banatanflorin/cric-piulita-rotitoare/Proiect O.M.-Bănățan Florin.pdf

1

UNIVERSITATEA TEHNICĂ DIN CLUJ-NAPOCA

Facultatea de Construcții de Mașini

Departamentul: Ingineria Sistemelor Mecanice

Disciplina: Organe de Mașini 1

## CRICUL CU PIULIŢĂ ROTITOARE

### Fmax =18 800 N

### hmax = 150 mm

Numele şi prenumele: BĂNĂȚAN PETRU-FLORIN

Anul, grupa: II, 2521/1

2020 – 2021

2

Universitatea Tehnică Cluj–Napoca

Facultatea de Construcții de Mașini

Departamentul: Ingineria Sistemelor Mecanice

Disciplina: Organe de Mașini 1

TEMA DE PROIECT

Studentul BĂNĂȚAN PETRU FLORIN , anul II , grupa 2521/1

Să se proiecteze un CRIC CU PIULIŢĂ ROTITOARE, pentru următoarele date:

- Forța maximă: Fmax =18 800N
- Cursa maximă: hmax =150 mm

Proiectul va cuprinde:

- Memoriul tehnic;
- Memoriul justificativ de calcul;
- Desen de ansamblu al mecanismului (3 vederi, scara 1/1);
- Desene de execuție pentru:
- șurubul principal;
- piuliță.
- Bibliografie;
- Cuprins.
Termen de predare | Conducător de proiect
25.05.2021 | ș. l. dr. ing. Claudiu POPA

3

CUPRINS:

I. MEMORIU TEHNIC
4. Justificarea claselor de precizie a ajustajelor și

II. MEMORIU JUSTIFICATIV DE CALCUL

7. Proiectarea mecanismului de acționare cu clichet

4

I.MEMORIU TEHNIC

Obiectul prezentului proiect este proiectarea unui dispozitiv cu șurub și piuliță, mai exact unui cric cu piuliță rotitoare, destinat atelierelor de lăcătușerie sau atelierelor mecanice, unde acesta și-ar găsi utilitatea. Dispozitivul mai sus amintit este fabricat în serie mică, executându-se numai la comandă, fiind utilizat frecvent de către un singur muncitor.

1.Considerente teoretice introductive:
Mecanismele de ridicat (cricurile) au in componenta lor cuple elicoidale de tip șurub-piuliță. Datorita simplității constructive, mecanismele șurub-piuliță se folosesc pentru transformarea mișcării de rotație in mișcare de translație sau invers, in condiții de transmitere ale unor sarcini sau având numai rol cinematic. Caracteristicile cinematice ale mecanismului sunt legate strict de elementul conducător.
Filetul atașat piesei cuprinzătoare si celei cuprinse permite cuplei elicoidale doua mișcări simultane, rotație si translație, intre care exista o relație cinematica: la o rotație completa deplasarea axiala este egala cu mărimea pasului filetului.

Utilizarea mecanismelor cu șuruburi de mișcare în construcția de mașini se datorează avantajelor pe care le prezintă:
- Construcția simplă și tehnologia de execuție ușor realizabilă
- Posibilitatea de transmitere a unor sarcini axiale mari utilizând forțe de acționare mici
- Raportul mare de transmitere i=πd2/p care duce la viteze mici
- Compactitatea construcției și gabarit redus
- Funcționarea lină și fără zgomot
- Posibilitatea de a asigura în mod simplu autofrânarea
- Permite utilizarea materialelor ieftine
- Preț de cost redus

5

Bineînțeles că mecanismele cu șuruburi de mișcare prezintă și următoarele dezavantaje:
- Existența unei frecări în spirele filetului șurubului și piuliței care conduce la uzura pieselor și la randament scăzut
- Prezența unor puternici concentratori de tensiune în zona filetată afectează rezistența la oboseală a șurubului
- Lipsa autocenzurii
Aceste dezavantaje pot fi reduse prin ungerea filetelor șurubului și a piuliței cu scopul de a îmbunătății performanțele cricului prin micșorarea frecării dintre flancurile filetelor. Totodată, prin ungere crește și randamentul mecanismului și se mărește durata sa de funcționare, scade nivelul zgomotelor ce pot apărea în cazul frecării uscate. Pentru ungere se va folosi o unsoare consistentă.

### 2. Alegerea filetului:

Filetul este o nervură elicoidală dispusă pe o suprafață cilindrică sau conică. În cazul șuruburilor această suprafață este exterioară, iar în cazul piulițelor ea este interioară. Există și un caz particular de filet când spirala este dispusă pe o suprafață plană. Din punct de vedere geometric, filetul poate fi generat de o figură pătrată, triunghiulară, trapezoidală sau semicerc, care are o mișcare elicoidală în jurul axei suprafeței de rotație. Pentru cric, știind că avem o deplasare relativ mică a șurubului și direcția forței rămâne constantă, am ales un filet trapezoidal oferind o serie de avantaje.
Filetul trapezoidal are o rezistență și o rigiditate mai mare ca
filetul pătrat. Folosirea | piuliței reglabile radial (secționată)
permite eliminarea jocului axial creat în urma uzurii flancurilor, avantaj care impune filetului trapezoidal ca principală soluție pentru mecanismele șurub-piuliță.
Filetul trapezoidal asigură o bună centrare între șurub și piuliță putându-se executa prin procedeul de frezare.
În cazul mecanismelor cu șurub și piuliță care transmit sarcini mari, în ambele sensuri, direcția forței fiind variabilă (sau cu șoc), se recomandă utilizarea filetelor trapezoidale.

6

Filetul este standardizat în STAS 2114/1-75, putând avea pas normal, fin sau mare. Valorile dimensiunilor sale se determină conform relațiilor de calcul, în funcție de diametrul
nominal și de pasul filetului.

### 3. Alegere materialelor:

Alegerea materialului se face astfel încât unul dintre elementele cuplei de frecare să fie confecționat din material antifricțiune. Materialele antifricțiunii sunt considerate printre cele mai bune materiale pentru lagăre, fiind caracterizate prin: temperatură scăzută de topire și proprietăți bune de turnare, rezistență ridicată la frecare și
compresiune la presiune și viteză mare, stabilitate înaltă la coroziune în diferite substanțe folosite pentru ungere, conductibilitate termică suficientă, aderență corespunzătoare la pereții lagărului, rezistență mare la uzură, precum și o ușoară prelucrare prin așchiere.
Atât în cazul șurubului, cât și în cazul piuliței , materialele se aleg în funcție de sarcina care acționează pe cupa cricului. Șurubul poate fi fabricat din oțeluri necălite sau oțeluri călite, iar piulița, care în general se efectuează din material antifricțiune pentru că este mai simplă și mai ieftină, poate fi fabricată din fonte cenușii, fonte cu grafit nodular sau bronzuri.
Pentru alte elemente ale cricului se aleg materiale din categoria oțelurilor, în majoritatea situațiilor, sau a fontelor.

### 4. Justificarea claselor de precizie a ajustajelor și

rugozităților:
În alegerea acestora trebuie să se ţină seama că aceste mecanisme nu lucrează la viteze mari şi nu se impune o precizie prea ridicată.
Rugozitătile se aleg în funcţie de rolul funcţional al pieselor, astfel pentru flancurile filetelor se alege o rugozitate de 1,6 pentru reducerea frecărilor şi mărirea randamentului, iar pentru restul suprafeţelor se vor alege rugozităţi de 3,2 și 6,3. Se pot alege şi alte rugozităţi dacă e justificat tehnologic şi constructive.

7

Pentru ajustajul filetat s-a ales precizia 8H/8e, fiind în acord cu destinația dispozitivului și tehnologia de execuție. Celelalte toleranțe la dimensiuni s-au ales conform unor clase și precizii medii, deoarece s-a considerat că nu este necesară impunerea unor precizii mai mari. Toleranțele s-au stabilit pe același criteriu, fiind impuse numai acolo unde ar fi existat pericolul unor disfuncții la montare sau demontare și în funcționare.

Condițiile tehnice impuse sunt următoarele:

- suprafețele funcționale și ansamblele componente se vor unge cu unsoare consistentă;
- suprafețele nefuncționale se protejează printr-un strat de vopsea;
- pe suprafețele pieselor turnate nu se admit urme de nisip, zgură sau bravuri provenite din turnare;
- muchiile necotate se vor teși la 45°

### 5. Prezentarea variantei constructive alese:

Variantele constructive ale cricului cu piuliță rotitoare sunt diversificate, diferențele dintre ele fiind legate de construcția corpului. Prima variantă de cric aleasă este cricul cu piuliță rotitoare care are următoarele particularități: corpul cricului este sudat și alcătuit din trei piese care pot fi obținute din semifabricate laminate, manivela cricului este cu clichet orizontal, corpul manivelei putându-se realiza prin forjare sau turnare. A doua variantă este cricul cu piuliță rotitoare, la care corpul este obținut prin turnare și roata de clichet este corp comun cu piulița. Cricul se acționează prin intermediul unei manivele cu clichet orizontal, care, pentru a putea fi montată, este executată cu două părți îmbinate prin intermediul unor șuruburi centrate cu ajutorul unor știfturi. Între extremitățile libere ale pieselor care formează manivela este introdusă o plăcuță de distanțare.

Deoarece ambele variante constructive au atât avantaje, cât și dezavantaje, am ales din fiecare formă părți constructive

8

pentru realizarea unei variante optime. Astfel cupa va fi fixată în partea superioară a șurubului printr-un știft standardizat, formând un alezaj cu joc. Pentru mecanismul de acționare am ales roate cu clichet orizontal fiind cea mai compactă. Roata de clichet se va fixa pe piuliță prin intermediul unei asamblări de formă hexagonală, iar tija, de care se prinde și clichetul utilizând un bolț, cu ajutorul unei piese inelare care este asigurată în partea superioară printr-un inel elastic. Piulița este împiedicată să facă mișcare de translație cu ajutorul unui știft filetat cu cep, asamblat prin corpul cricului. Pentru a evita frecarea dintre piuliță și corp se folosește un rulment axial cu rol în protecția la uzură. Pentru că producția va fi de serie mică, corpul cricului se va realiza prin sudura a trei piese. Șurubul va fi fixat de corp în partea inferioară cu ajutorul unui știft standardizat cu rolul de a împiedica mișcarea de rotație a șurubului și de a-l opri pe acesta la capătul cursei.

### 6. Funcționare:

Principiul de funcționare este relativ simplu realizându-se astfel: la rotirea manivelei mișcarea se transmite prin piuliță, care se sprijină pe rulment, la șurub care va face o mișcare de translație, cu ajutorul căruia se deplasează cupa.

Pentru o bună funcționare dispozitivul trebuie să îndeplinească următoarele condiții:

- Mânuire, antrenare, manipulare ușoară
- Gabarit cât mai redus
- Curse utile cât mai mici
- Siguranța în funcționare
- Posibilitatea de producere a accidentelor cât mai redusă
- Posibilitatea mânuirii fără a necesita scule sau dispozitive speciale

9

### 7. Indicii de exploatare, reglaj și întreținere:

Dispozitivul se va manevra de către un singur muncitor, nefiind permisă, pentru manipulare, folosirea altor țevi, bare, prelungitoare decât cele prevăzute de proiectant, sau sistemelor de pârghii.

Este indicat ca dispozitivul să fie montat pe suprafețe cât mai plane și orizontale.

Dispozitivul se va folosi pentru sarcini și dimensiuni care nu va depăși limita pentru care a fost proiectat.

Se vor verifica periodic flancurile filetului, iar în caz că se constată uzura acestora, se va schimba piulița sau șurubul dacă este cazul.

După fiecare utilizare dispozitivul se va curăța, suprafețele funcționale se vor unge cu unsoare consistentă de uz general.

### 8. Norme de protecția muncii:

Pentru a evita accidentele, proiectantul a luat următoarele măsuri:

✓ Verificarea șurubului la solicitării compuse
✓ Asigurarea și verificarea asamblării
✓ Utilizarea de materiale corespunzătoare

Măsuri impuse beneficiarului:

✓ Trebuie respectate regulile de protecție a muncii din atelierul de producție
✓ Personalul de lucru trebuie să fie instruit corespunzător ✓ Dispozitivul de strângere nu se va supune la șocuri și lovituri directe
✓ La apariția unei defecțiuni se va retrage dispozitivul din lucru și se va înlocui piesa defectă
✓ Asamblarea șurub-piuliță se va unge periodic cu unsoare consistentă

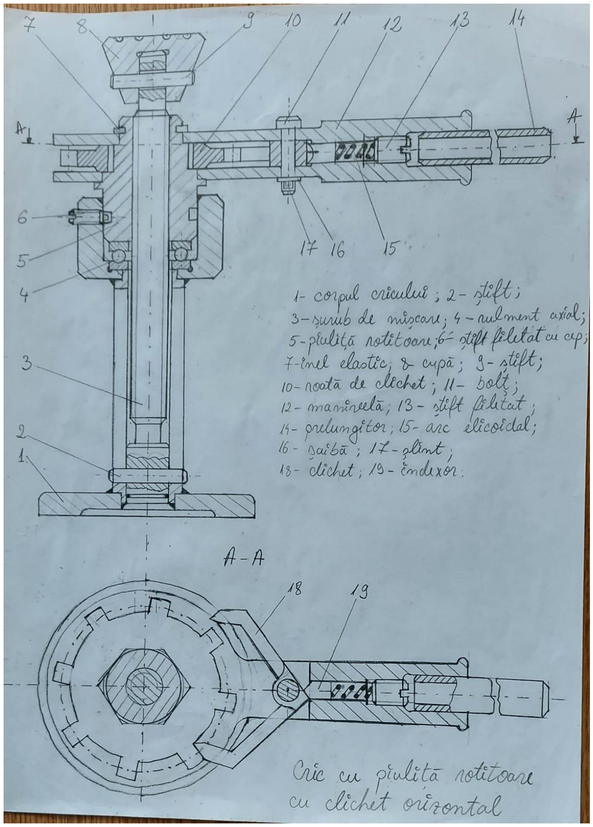
[picture p1: figure]

10

### 9. Schiță constructivă:

### II. MEMORIU JUSTIFICATIV DE CALCUL

Date de intrare: F≔18800 N
x≔150 mm
1.Dimensionarea asamblării filetate:

Se utilizează FILETUL TRAPEZOIDAL deoarece transmite sarcină în ambele sensuri, având coeficientul înălțimii spirei:
ψh≔0.5

Se adoptă coeficientul lungimii filetate a piuliței: ψm ≔2

Alegerea materialelor:
-ȘURUBUL se realizează din oțel călit 2C45** cu rezistențele admisibile, preluate din tabelul 1.3:

rezistența la tracțiune: σats≔87 MPa σacs≔87 MPa rezistența la încovoiere: σais≔100 MPa
rezistența la torsiune: τats≔55 MPa
rezistența la forfecare: τafs≔70 MPa

-PIULIȚA se realizează din material cu proprietăți antifricțiune, mai exact fontă cu grafit nodular EN-GJS-400-18 cu rezistențele admisibile, preluate din tabelul 1.4:

rezistența la tracțiune: σatp≔49 MPa rezistența la compresiune: σacp≔123 MPa rezistența la încovoiere: σaip≔83 MPa rezistența la torsiune: τatp≔59 MPa rezistența la forfecare: τafp≔39 MPa

În urma alegerii materialelor se adoptă, cu ajutorul tabelului 1.6 , tensiunile admisibile și coeficienți de frecare pentru cuplul oțel călit/fontă cu grafit nodular:

suprafețe mobile: pa≔8 MPa suprafețe imobile: σas≔40 MPa coeficientul de frecare: μ≔0.10

d2nec≔ | =
――F――― π⋅ψ ⋅ | ⋅ h ψm pa

### 27.35 mm

11

Se adoptă β≔1.3

d3nec≔ | =

―4 ⋅β―⋅F― π⋅σacs
18.912 mm
Se adoptă elementele standardizate ale filetului la care d | ≥ | și | . 2stas d2nec | d3stas≥d3nec

Se adoptă filetul trapezoidal 32 cu elementele standardizate, preluate din tabelul 1.1:
d≔32 mm
P≔6 mm
D2≔29 mm
d2≔29 mm
D4≔33 mm
d3≔25 mm
d1≔26 mm
ac≔0.5 mm

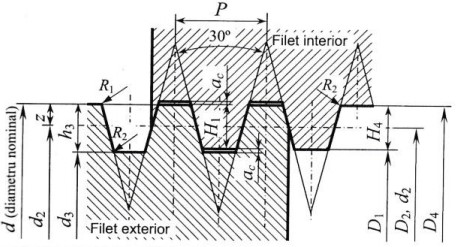
[picture p2: figure]

Se adoptă numărul de începuturi n=1 pentru îndeplinirea condiției de autofrânare:

α1≔15 °

β2≔atan | =

⎛
⎜
⎝

―P―π⋅d2

⎞
⎟
⎠
3.768 ° | φ'≔atan | =

⎛
⎜
⎝

――μ ― cos ⎛⎝α1
⎞
⎠

⎞
⎟
⎠

5.911 °

Concluzie: Este îndeplinită condiția de autofrânare β2<φ'

Momentul de înfășurare T se calculează cu relația: 1

T1≔―⋅ ⋅ ⋅ | =

1
2

F d2 tan⎛⎝β2+φ'⎞
⎠

⎛⎝4.649 ⋅ 10⁴ ⎞
⎠ N ⋅mm

Calculul numărul de spire:

z≔―――=

ψm ⋅d2
P

9.667

Se îndeplinește condiția: 6≤z≤11

Calculul lungimii filetului piuliței:

m≔z ⋅P=58 mm

Se adoptă dimensiunile pentru rulment, cu ajutorul tabelului A16.1 și a condiției: drul>d

drul≔35 mm | Hrul≔12 mm
Drul≔52 mm | μrul≔0.01
12.

Calculul lungimii filetului șurubului:

Lf≔x+m+Hrul+3 ⋅P=238 mm
2.Proiectarea formei șurubului

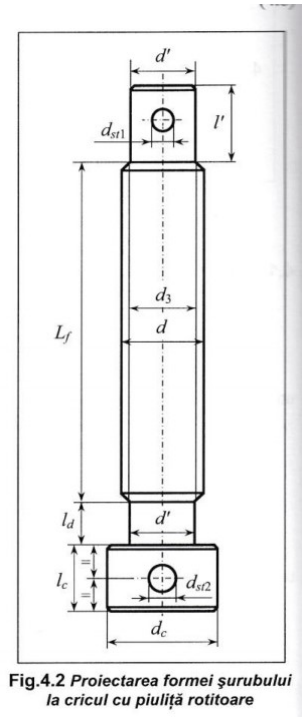
[picture p3: figure]

Se alege d'<d3stas

d'≔24 mm

Lungimea degajării:

ld≔2 ⋅P=12 mm

dc≔d+5 mm =37 mm

lc≔0.8 ⋅dc=29.6 mm

lc≔30 mm

Calculul diametrelor știfturilor:

dst1≔0.3 ⋅d'=7.2 mm

dst2≔0.3 ⋅dc=11.1 mm

Se adoptă știfturi cilindrice de forma B cu diametrele, cu ajutorul Anexei 10:

dst1≔8 mm

dst2≔12 mm

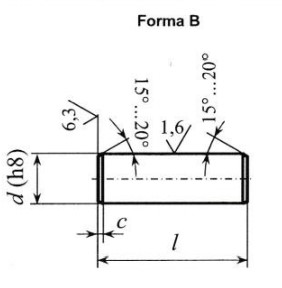
[picture p4: figure]

3.Verificarea șurubului

### 3.1. Verificarea tijei șurubului

Verificarea la solicitări compuse:

σc≔―――=

4 ⋅F
π⋅d ⋅ 3 d3

38.299 MPa

T'≔0.5 ⋅T1=⎛⎝2.325 ⋅ 10⁴ ⎞
⎠ N ⋅mm
τt≔―――= | 13 16 ⋅T'
π⋅d3

3

7.577 MPa

σech≔ σ
c

+ =

2 3 ⋅τt

2 40.485 MPa <= σacs=87 MPa

Verificarea la flambaj:

Lungimea de flambaj: lfl≔2 ⋅x=300 mm

Coeficientul de zveltețe: imin≔―=

| d3
| 4 6.25 mm
| λ≔――= lfl imin
| 48

Verificarea la flambaj nu este necesară deoarece λ≤60

### 3.2 Verificarea spirelor șurubului

H1≔0.5 ⋅P=3 mm

h≔0.634 ⋅P=3.804 mm

σi≔―――――=

6 ⋅F⋅

⎛
⎜

⎝――+

H1
2

ac

⎞
⎟
⎠
z ⋅π⋅d ⋅ 3 h

2

20.535 MPa <=σais=100 MPa

τf≔――――=

F
z ⋅π⋅d ⋅ 3 h

### 6.51 MPa <=τafs=70 MPa

### 4. Proiectarea cupei

dc1≔2.5 ⋅d=80 mm | hc≔1.5 ⋅d=48 mm
dc2≔d'+12 mm =36 mm | hcs≔hc-10 mm =38 mm

y≔――=

hcs
2
19 mm | l'≔hcs+4 mm =42 mm

d''≔d'-2 mm =22 mm

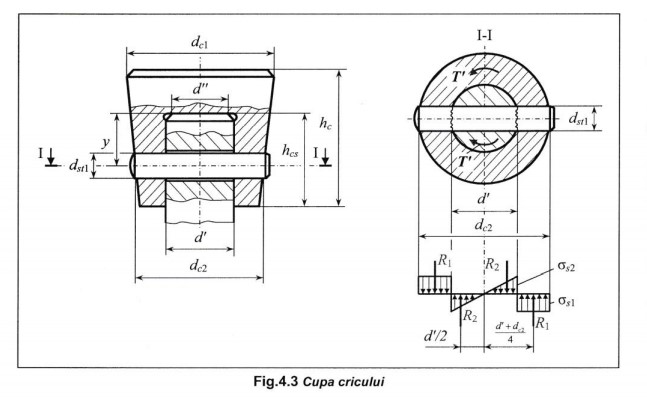
[picture p5: figure]

14

Verificarea cupei:

Deoarece cupa și știftul sunt efectuate din oțel, vom alege din tabelul 1.6 tensiunea admisibilă: σas≔65 MPa

σs≔―――=

4 ⋅F
π⋅d''²

49.456 MPa <=σas=65 MPa

Alegerea știftului care solidarizează cupa de șurub:

Se adoptă un știft din oțelul E295 cu rezistențele admisibile, preluate din tabelul 1.3:

rezistența la tracțiune: σat≔140 MPa σac≔140 MPa rezistența la încovoiere: σai≔161 MPa
rezistența la torsiune: τat≔91 MPa
rezistența la forfecare:τaf≔112 MPa
dst1=8 mm | dst2=12 mm

Momentul de frecare: Tf≔―⋅ ⋅ ⋅ =

1
3
| μ F d'' ⎛⎝1.379 ⋅ 10⁴ ⎞
⎠ N ⋅mm

Momentul care solicită știftul: Tst≔T'-Tf=⎛⎝9.459 ⋅ 10³ ⎞ ⎠ N ⋅mm

Verificarea știftului:

Solicitarea știftului la forfecare și la strivire:

τf≔――――=

4 ⋅Tst π⋅d'⋅dst1
2 | 7.841 MPa <=τaf=112 MPa

Solicitarea dintre cupă și știft:

σs1≔―――――=

4 ⋅Tst

d ⋅ st1

⎛
⎝dc -

### 2 d'² ⎞

⎠

| 5.964 MPa <=σas=65 MPa

Solicitarea dintre știft și cupă:

σs2≔―――=

6 ⋅Tst
d ⋅ st1 d'²

12.316 MPa <=σas=65 MPa

15

Verificarea capului șurubului la solicitări compuse:

σc≔―――――=

F

―――-

π⋅d'²
4

d ⋅ st1 d'

### 72.2 MPa

τt≔――――――=

### 16 T'

π⋅d' ⋅

3

⎛
⎜
⎝

1-――

dst1
d'

⎞
⎟
⎠

12.846 MPa

σech≔ σ
c

+ =

2 3 ⋅τt

2 | 75.55 MPa | <= σacs=87 MPa

5.Dimensionarea piuliței:

De≔Drul+6 mm =58 mm

l1≔0.4 ⋅Hrul=4.8 mm

Se adoptă, cu ajutorul Anexei 5, știftul pentru fixarea piuliței: știft filetat cu locaș hexagonal cu cep cilindric STAS 5171 M6:

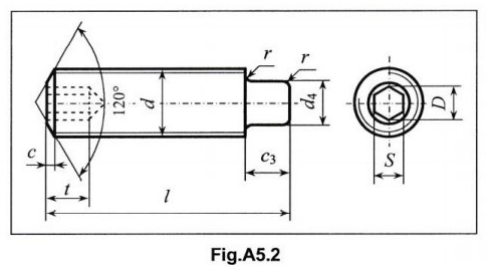
[picture p6: figure]

S≔3 mm | c≔0.5 mm
D≔3.5 mm | c3≔3 mm
t≔4 mm | r≔0.25 mm
d4≔4 mm | l≔25 mm
dsf≔6 mm

dci≔De-2 ⋅ c3-2 mm =50 mm

lci≔dsf=6 mm

l2≔2 ⋅dsf=12 mm

Dg≔De+6 mm =64 mm

hg≔5 mm

l3≔4 mm

―=

De
2

### 29 mm

Se adopta latura hexagonului a după relația: a<―

| | De 2 => a≔28 mm

Deschiderea cheii: S≔1.73 ⋅a=48.44 mm
16

Se adoptă diametru pe care se montează manivela cu ajutorul formulei: dm ≤S

dm ≔48 mm

Se alege inelul elastic in funcție de diametrul arborelui din Anexa 12: Inel elastic excentric pentru arbori (STAS 5848/2):

d1_inel≔45.5 mm | b1inel≔1.85 mm | nmin_inel≔3.8 mm
rinel≔3.8 mm | sinel≔1.75 mm | binel≔5 mm | l inel≔6 mm

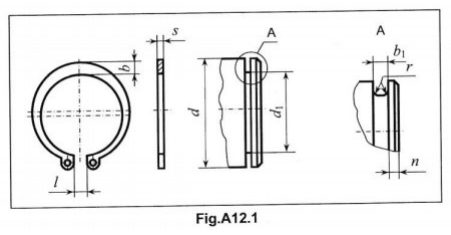
[picture p7: figure]

Se adoptă lățimea dintelui de clichet: δ≔10 mm

δt≔δ+2 mm =12 mm

δ1≔0.5 ⋅ δ=5 mm

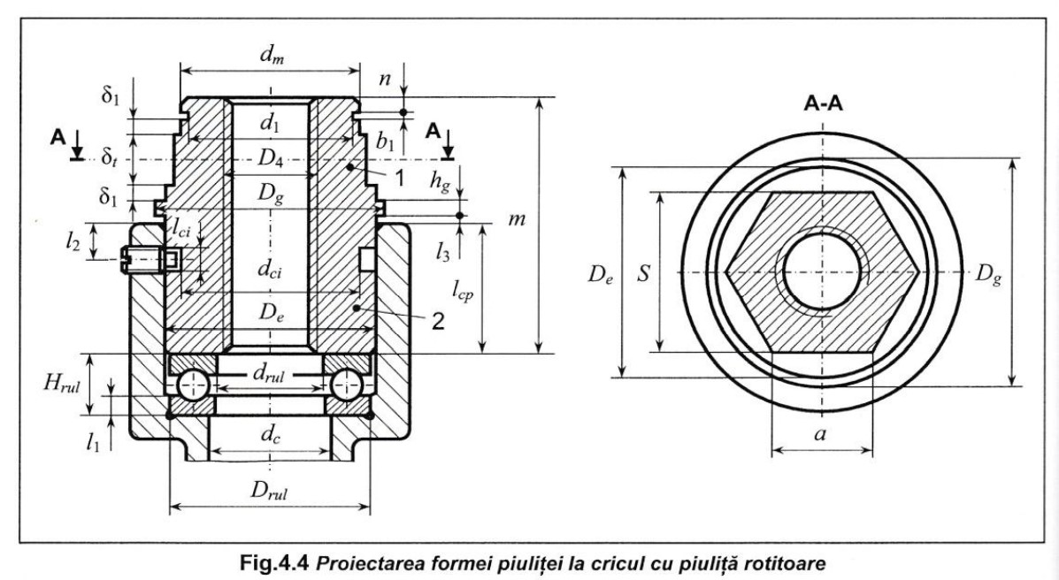
[picture p8: figure]

lcp≔0.7 ⋅ De=40.6 mm => lcp≔41 mm

Se calculează lungimea totală a piuliței:

Lpiul≔nmin_inel+b1inel+δ1+δt+δ1+hg+l3+lcp=77.65 mm | 17

T2≔―⋅ | ⋅ | ⋅ =

1
2

μrul drul F ⎛⎝3.29 ⋅ 10³ ⎞ ⎠ N ⋅mm

T≔T1+T2=⎛⎝4.978 ⋅ 10⁴ ⎞
⎠ N ⋅mm

### 6. Verificarea piuliței

### 6.1 Verificarea corpului piuliței:

ZONA 1:

σs≔――=

| 2 ⋅T a ⋅ 2 δ1 | 25.399 MPa <= σas=65 MPa

ZONA 2:

σc≔―――――=

| | 4 ⋅F
| π⋅ ⎛ | ⎝dci - 2 D4

2 ⎞
⎠

16.964 MPa

τt≔―――――=

16 ⋅T ⋅ 1 dci
π⋅ ⎛
⎝dci -

### 4 D4

4 ⎞
⎠

2.338 MPa

σech≔ σ
c

+ =

2 3 ⋅τt

2 | 17.441 MPa | <= σacp=123 MPa

### 6.2 Verificarea spirelor piuliței:

σi≔―――――=

6 ⋅F⋅

⎛
⎜

⎝――+

H1
2

ac

⎞
⎟
⎠
z ⋅π⋅ D ⋅ 4 h

2

15.557 MPa <= σaip=83 MPa

τf≔――――=

F
z ⋅π⋅ D ⋅ 4 h
4.931 MPa | <= τafp=39 MPa

18

### 7. Proiectarea mecanismului de acționare cu clichet

orizontal:

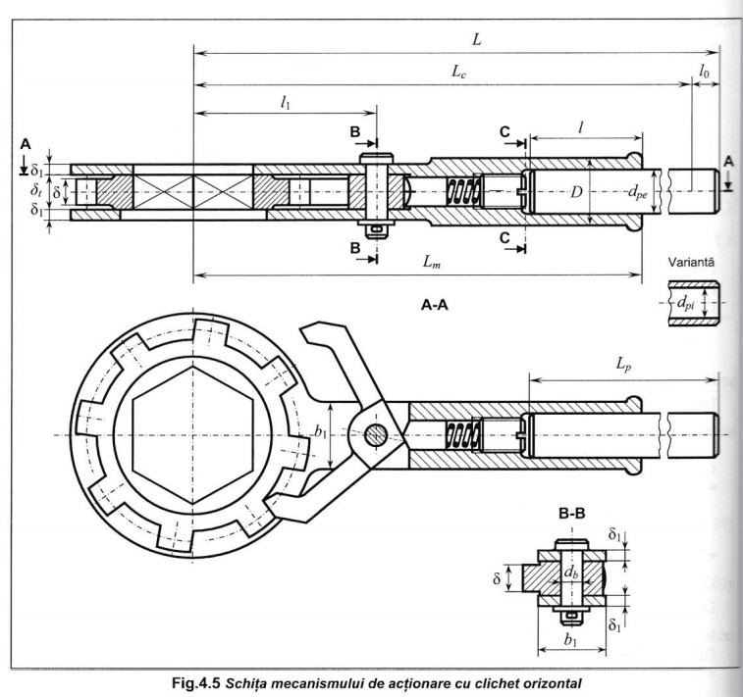
[picture p9: figure]

### 7.1 Calculul lungimii manivelei:

Se adoptă forța cu care acționează operatorul: Fm ≔150 N

Lc≔――=

T
Fm

331.875 mm

Se adoptă lungimea suplimentară pentru prinderea cu mâna a manivelei: l0≔50 mm

L≔Lc+l0=381.875 mm | => L≔382 mm
7.2 Calculul prelungitorului: | L>300 mm

Lm ≔0.3 ⋅L=114.6 mm

Se adoptă lungimea de ghidare a prelungitorului: l≔50 mm

19

Lp≔L-Lm +l=317.4 mm

Prelungitorul este executat din BARĂ, executată la rândul ei din oțelul E295

dpe≔ | =

3 ――――――

32 ⋅Fm ⋅ ⎛⎝Lp-l0-l⎞
⎠
π⋅σai
12.73 mm | => dpe≔14 mm
Diametrul manivelei: | Dmanivelă≔dpe+10 mm =24 mm

b1≔Dmanivelă=24 mm

### 7.3 Verificarea manivelei:

Încovoierea din secțiunea C-C:

σi≔―――――――――――=

Fm ⋅ ⎛⎝Lc-Lm +l⎞
⎠
――――⋅

π

32 ⋅ Dmanivelă

⎛
⎝Dmanivelă -

### 4 dpe

4 ⎞
⎠

33.409 MPa <= σai=161 MPa

Încovoierea din secțiunea B-B:

Se adoptă diametru bolțului cu ajutorul Anexei 11: db≔10 mm

σi≔――――――=

Fm ⋅ ⎛⎝Lc-l1

⎞
⎠
2 ⋅ ⎛ | ⋅ ⎝b1-db

⎞
⎠

2 ―

δ1
6

150.188 MPa <= σai=161 MPa

20

### 7.4 Proiectarea roții de clichet:

Roata de clichet se execută din oțelul E295

Dm ≔1.8 ⋅ De=104.4 mm

Se alege numărul de dinți: z≔8

―――=

π⋅ Dm
2 ⋅ z

20.499 mm => b≔20 mm

h≔0.8 ⋅ b=16 mm

Dir≔Dm -h=88.4 mm | => Dir≔89 mm
Der≔Dm +h=120.4 mm | => Der≔121 mm

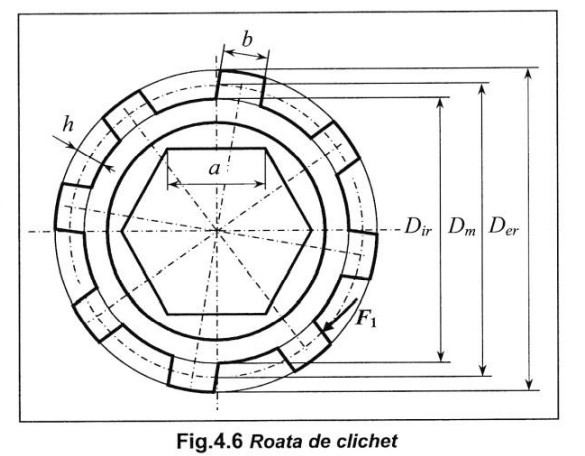
[picture p10: figure]

### 7.5 Verificarea roții de clichet:

Verificarea dintelui la strivire:

F1≔――=

2 ⋅T
Dm

953.664 N

σi≔―――=

3 ⋅F ⋅ 1 h
b ⋅

### 2 δ

11.444 MPa <= σai=161 MPa

Verificarea dintelui la forfecare:

τf≔――=

F1
b ⋅ δ

4.768 MPa <= τaf=112 MPa

21

Verificarea suprafeței de contact dintre dinte și clichet la strivire:

σs≔――=

F1
δ ⋅h

### 5.96 MPa <= σas=65 MPa

### 7.6 Proiectarea clichetului

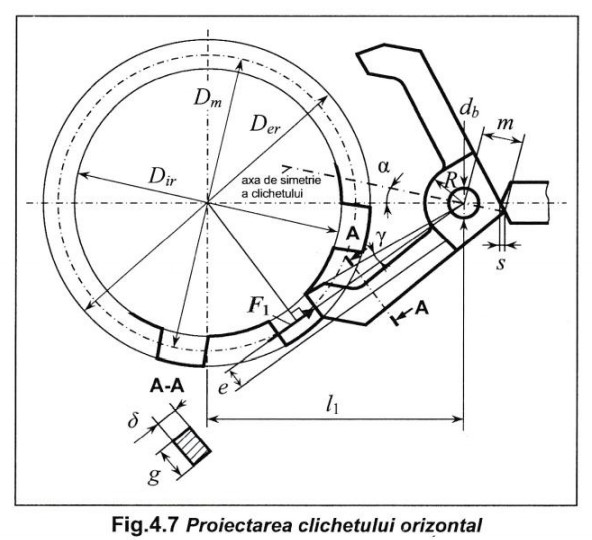
[picture p11: figure]

l1≔1 ⋅ Dm =104.4 mm

γ≔2 ⋅atan | =

⎛
⎜
⎝

――⋅

π
4 ⋅ z

tan

⎛
⎜
⎝

asin

⎛
⎜
⎝

――

Dm
2 ⋅l1

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
6.488 °

α≔γ+4 ° =10.488 °

R≔db=10 mm

m≔2.2 ⋅db=22 mm

Din dezvoltarea constructivă => g≔10 mm
e≔6 mm

### 7.7 Verificarea clichetului la compresiune excentrică:

σtot≔―――+ =

6 ⋅F ⋅ 1 e
g ⋅

### 2 δ ――

F1
g ⋅ δ

43.869 MPa <= σai=161 MPa

22

### 7.8 Verificarea bolțului:

Verificarea bolțului la forfecare:

τf≔――――=

F1

2 ⋅―――

π⋅db

2
4

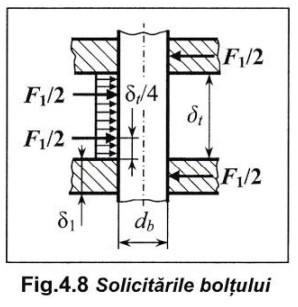
[picture p12: figure]

6.071 MPa <= τaf=112 MPa

Verificarea la strivire a suprafețelor de contact dintre bolț și manivelă:

σs≔――=

F1
d ⋅ b δt

7.947 MPa <= σas=65 MPa

Verificarea bolțului la încovoiere:

σi≔―――――=

8 ⋅F ⋅ 1

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
π⋅db

3

26.713 MPa <= σai=161 MPa

### 7.9 Calculul arcului cilindric elicoidal de compresiune:

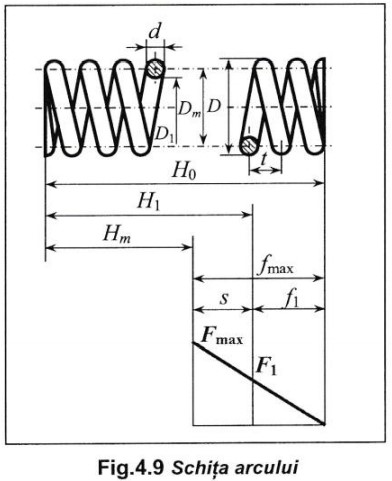
[picture p13: figure]

Calculele se efectuează pe baza relațiilor
de calcul din tabelul 4.1

Se adoptă:

indicele arcului: i≔8
coeficientul de formă: K≔1.2 diametrul spirei: dsp≔0.8 mm forța de montaj: F1≔5 N
numărul de spire active: n≔5 numărul spirelor de capăt: nc≔1.5

Dm ≔i⋅dsp=6.4 mm

nt≔n+nc=6.5

G≔⎛⎝8.5 ⋅ 10⁴ ⎞
⎠ MPa

f1≔――――⋅ =

8 ⋅F ⋅ 1 Dm

3
G⋅dsp

4

n 1.506 mm
23

s≔2 mm

fmax≔f1+s=3.506 mm

Fmax≔F1

⋅――=

fmax
f1

11.641 N

Arcul este confecționat din oțel C65A => τat≔650 MPa

τtM ≔―――――=

8 ⋅K⋅Fmax ⋅ Dm
π⋅dsp

3

444.639 MPa

――+ | =

Dm
4
0.2 mm 1.8 mm | ―⋅ | =
| 2
| 3 | Dm 4.267 mm
1.8 mm≤t≤4.267 mm | => t≔3 mm

e≔0.5 mm

H0≔n⋅t+⎛⎝nc-0.5⎞
⎠

⋅t=18 mm

H1≔H0-f1=16.494 mm

Hm ≔H0-fmax=14.494 mm

D≔Dm +dsp=7.2 mm

D1≔Dm -dsp=5.6 mm

α0≔atan | =

⎛
⎜
⎝

―t―― π⋅ Dm

⎞
⎟
⎠

8.486 °

l

s≔――――=

π⋅ Dm ⋅nt
cos ⎛⎝α0

⎞
⎠

132.137 mm

### 8. Proiectarea corpului cricului:

Corpul cricului este executat din oțel E295 => σac≔140 MPa

Se adoptă : l4≔4 mm
lc≔5 mm

l≔lc+――+ =

Hrul
2

lcp 52 mm

b'≔10 mm
D6≔dc+10 mm =47 mm
D7≔D6-6 mm =41 mm | 24

Trebuie să fie respectată condiția: ―――≥

D7-dc
2

### 2 mm

D8≔D7+40 mm =81 mm >=80mm

Copul cricului este așezat pe beton=> σas≔2 MPa

D9≔ | =

―――+

4 ⋅F
π⋅σas

D8

| 2 136.123 mm

=> D9≔140 mm

Trebuie să fie respectată condiția:

### 20 mm≤―――≤

D9- D8
2
| 50 mm

h'≔x+dst2=162 mm

H'1≔h'+lc+b'+8 mm =185 mm

H≔H'1+l-lc=232 mm

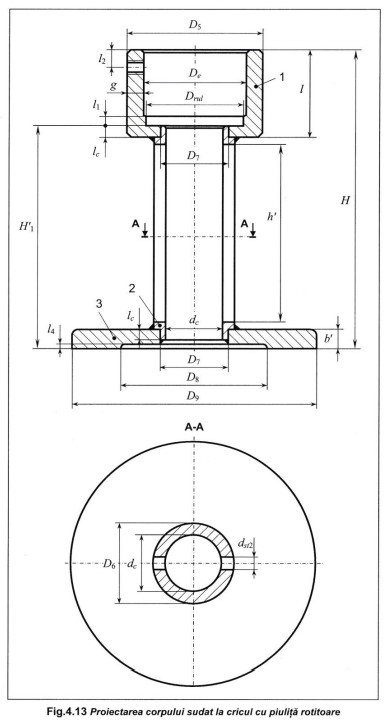
[picture p14: figure]

Verificarea corpului la compresiune în secțiunea A-A:

σc≔――――――――――=

4 ⋅F
π⋅ ⎛
⎝D6 - -

### 2 dc

2 ⎞
| ⎠ 4 ⋅d ⋅ st2 ⎛⎝D6-dc

⎞
⎠

34.832 MPa <= σac=140 MPa

9.Calculul randamentului transmisiei:

η≔――――――――=

tan⎛⎝β2

⎞
⎠

tan⎛⎝β2+φ'⎞
⎠+――⋅

drul
d2

μrul

0.361

25

BIBLIOGRAFIE:

- TRANSMISII CU ȘURUBURI: Calcul și proiectare-Simion HARAGÂȘ, Dumitru POP, Ovidiu BUIGA
- https://fdocumente.com/document/model-proiect-cric-cu-piulita-rotitoare.html (https://fdocumente.com/document/model-proiect-cric-cu-piulita-rotitoare.html)
- https://vdocuments.net/memoriu-tehnic-cric-cu-piulita-rotitoare.html (https://vdocuments.net/memoriu-tehnic-cric-cu-piulita-rotitoare.html)
- http://www.worldindustry.ro/index.php?option=com_content&view=article&id=73&Itemid=43 (http://www.worldindustry.ro/index.php?option=com_content&view=article&id=73&Itemid=43)

26

A

A

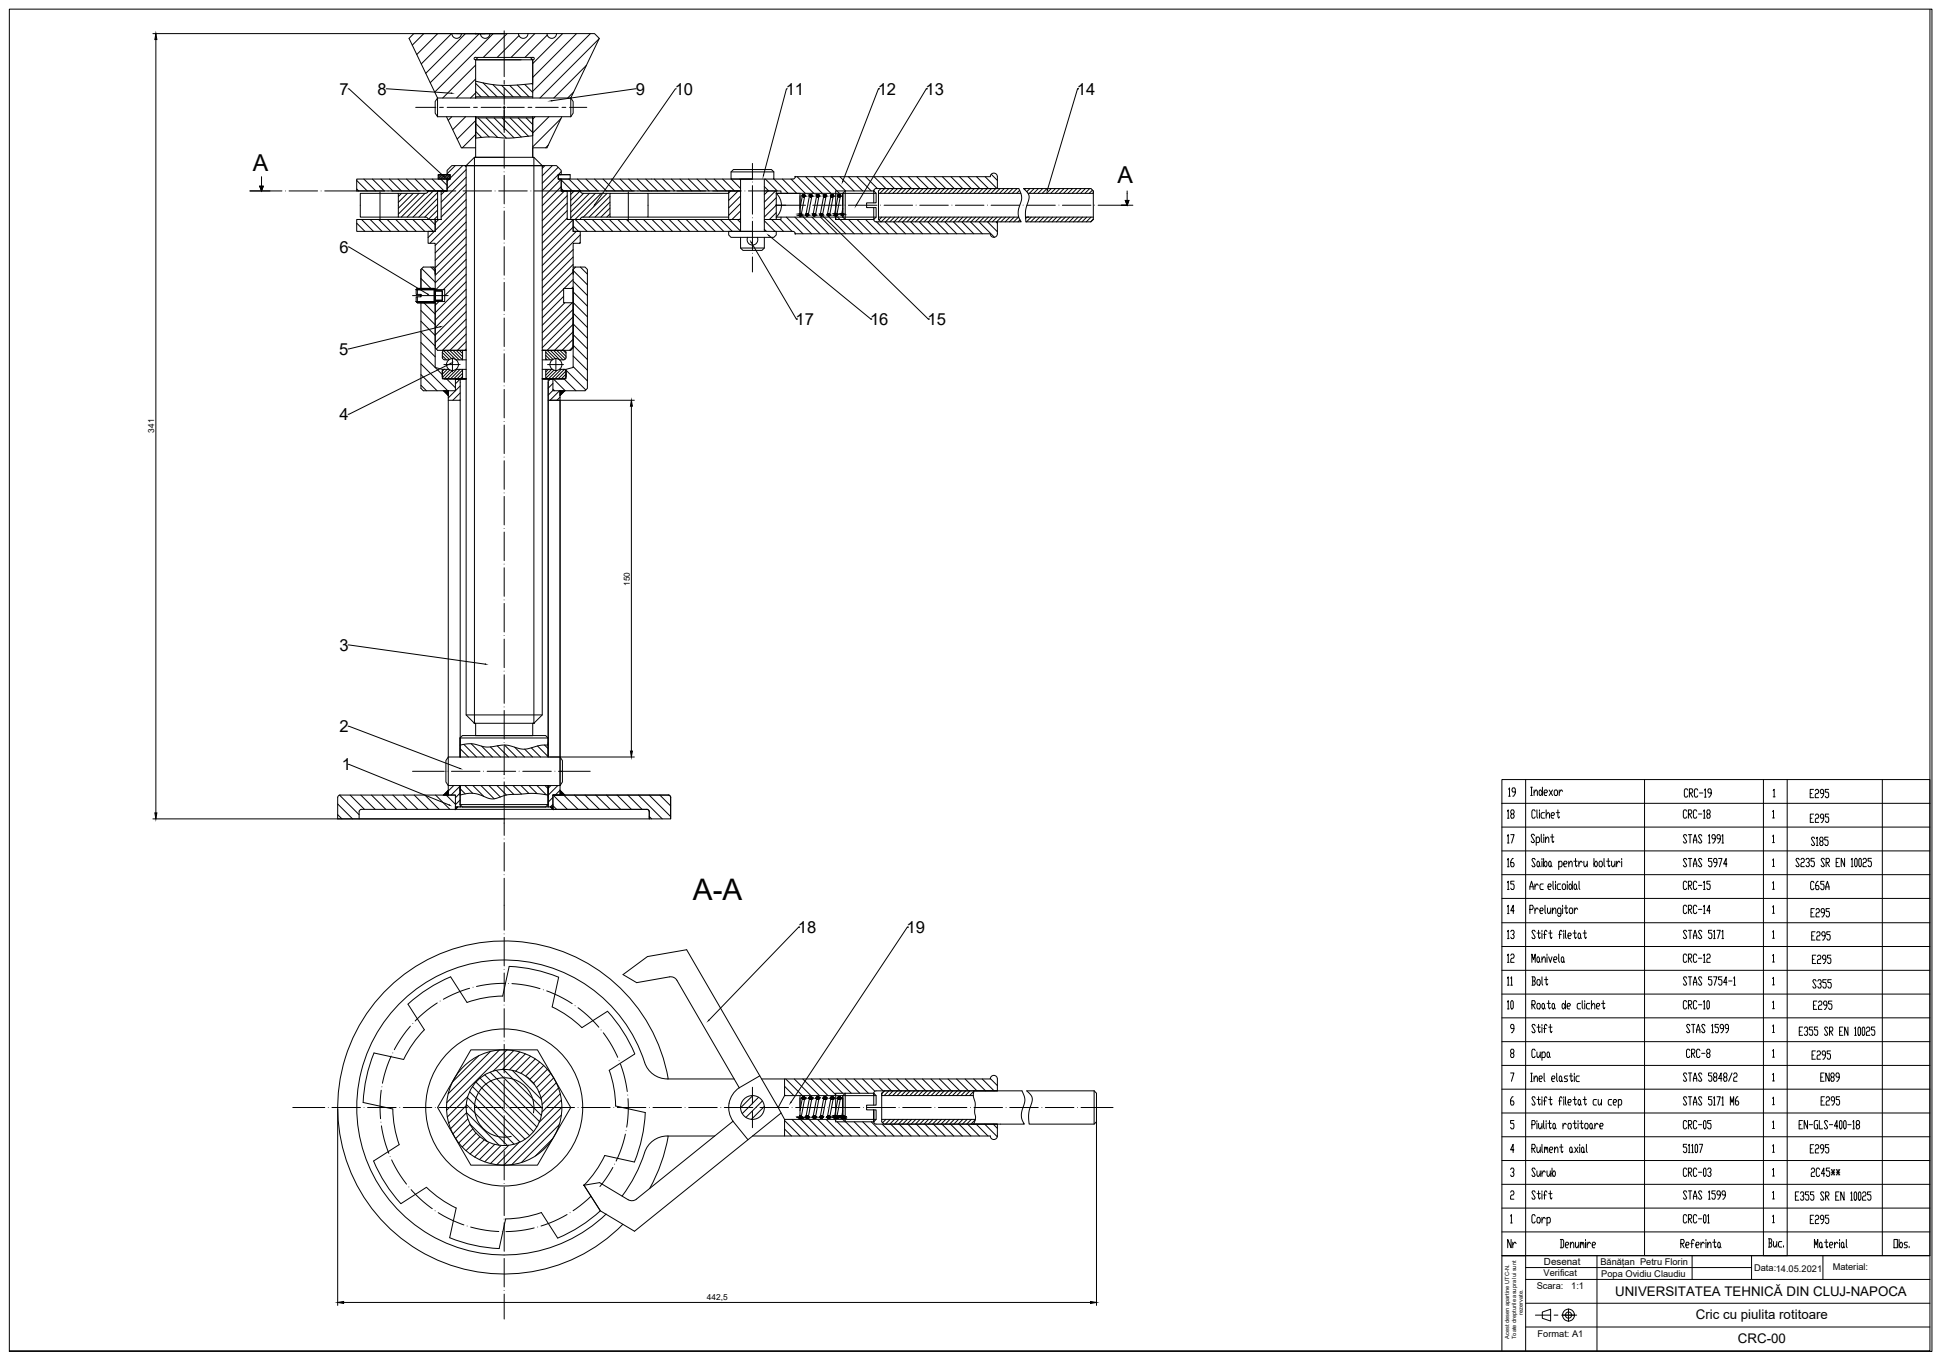
[picture p15: page 27]
Desenat; Verificat; Data:; Material:; Scara: 1:1; UNIVERSITATEA TEHNICĂ DIN CLUJ-NAPOCA Acest desen apartine UTC⁻N. Toate drepturile asupra lui sunt; Format: A1 rezervate.; CRC-00 ³⁴¹ 442,5 ¹⁵⁰

Bănățan Petru Florin
Popa Ovidiu Claudiu

Cric cu piulita rotitoare

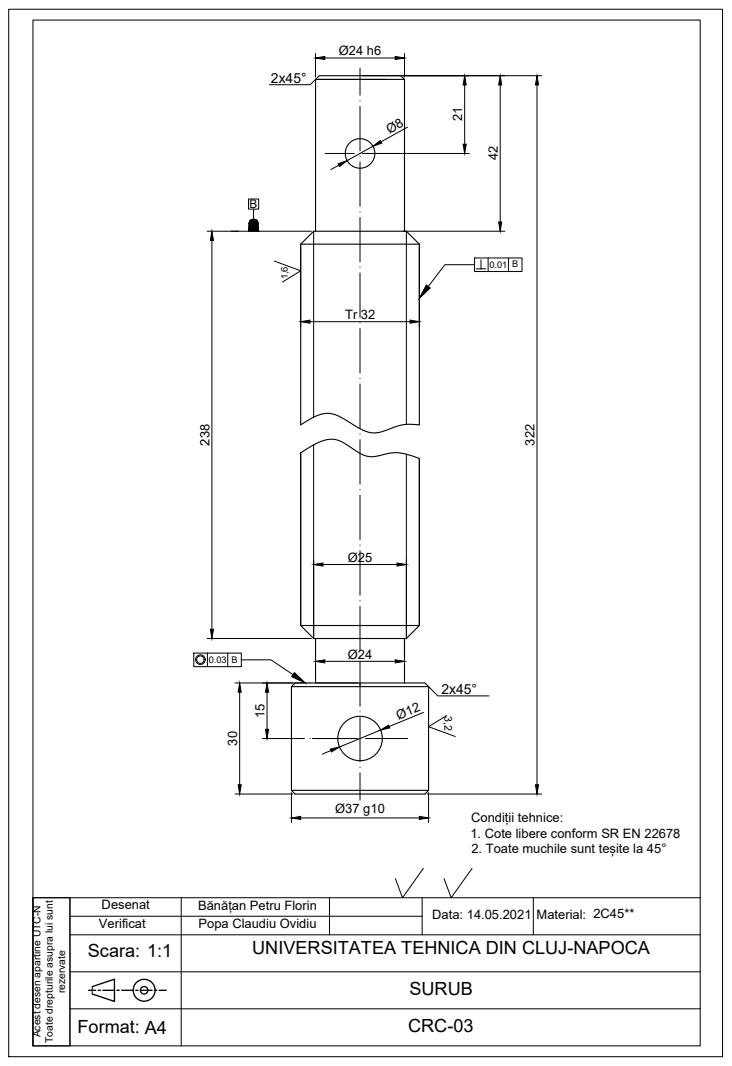
[picture p16: page 28]
Data: 14.05.2021; Material:; Format:; Scara:; Verificat; Desenat; SURUB; CRC-03 ¹,6

Condiții tehnice:
1. Cote libere conform SR EN 22678
2. Toate muchile sunt teșite la 45°

2C45** Acest desen apartine UTC⁻N Toate drepturile asupra lui sunt rezervate

Bănățan Petru Florin
Popa Claudiu Ovidiu

UNIVERSITATEA TEHNICA DIN CLUJ-NAPOCA

C | C

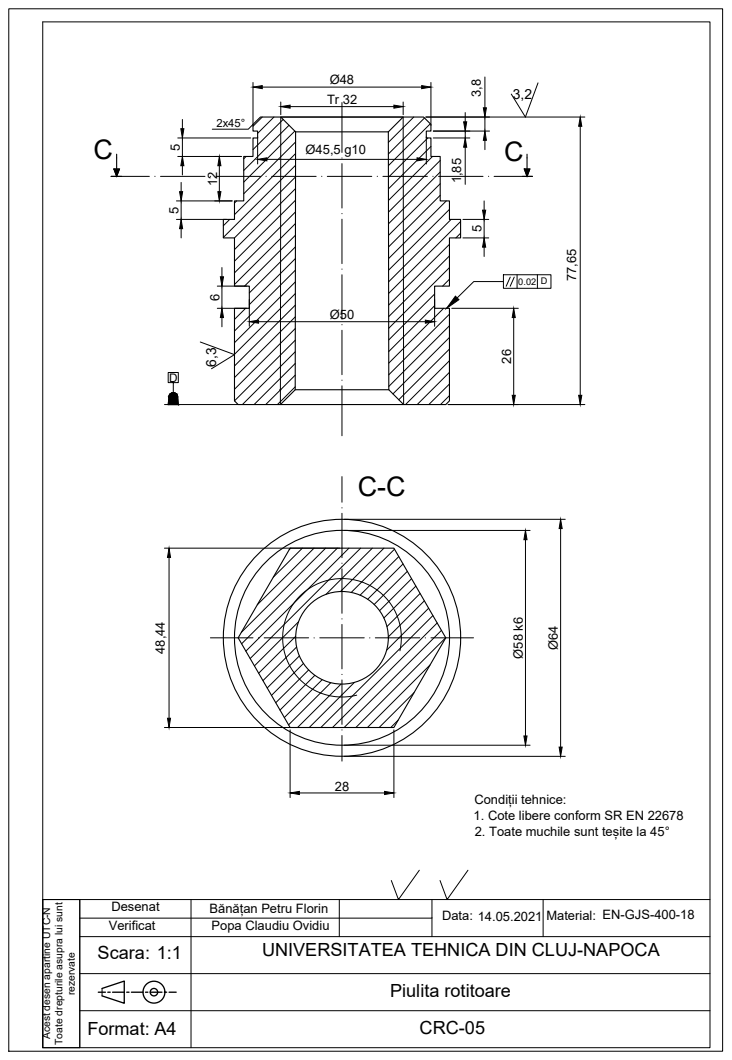
[picture p17: page 29]
Data:; Material:; Format:; Scara:; Verificat; Desenat; Piulita rotitoare; Popa Claudiu Ovidiu; CRC-05 ⁶,3

Condiții tehnice:
1. Cote libere conform SR EN 22678
2. Toate muchile sunt teșite la 45°

EN-GJS-400-18 Acest desen apartine UTC⁻N Toate drepturile asupra lui sunt rezervate

Bănățan Petru Florin
UNIVERSITATEA TEHNICA DIN CLUJ-NAPOCA
