banatanflorin/cric-piulita-rotitoare/(list of files, cad)

Other CAD files:
Piulita.dwg
Drawing1.dwg
Surub.dwg
